knst-wrk/ipled/DSCF0306.JPG

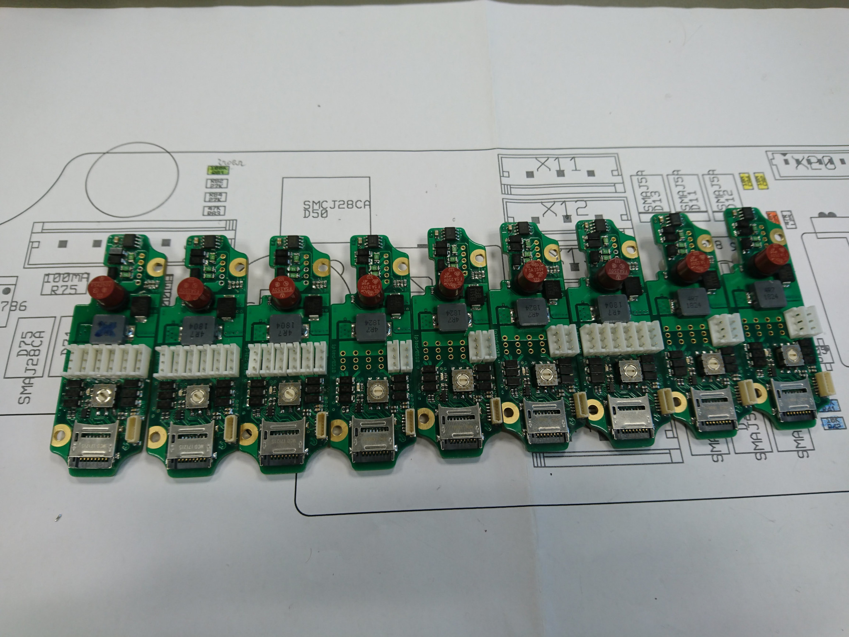
DSCF0306.JPG
