knst-wrk/ipled/DSCF5322.JPG

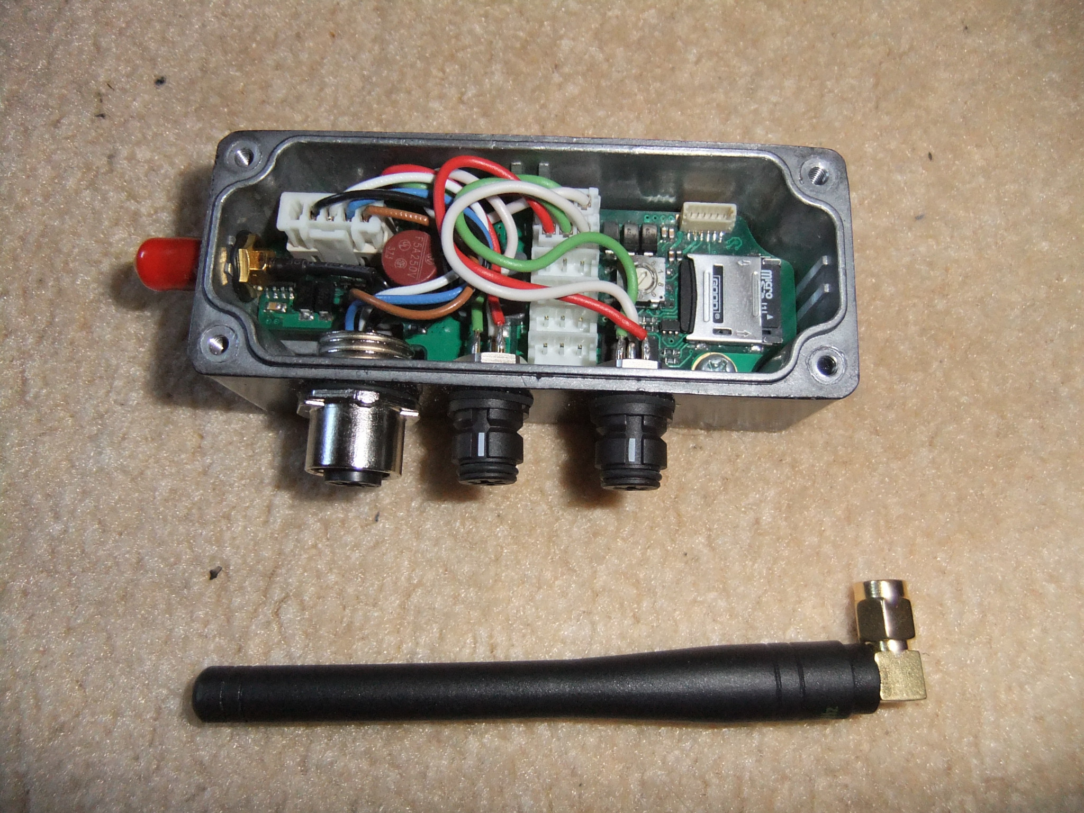
DSCF5322.JPG
