knst-wrk/ipled/rfspec.png

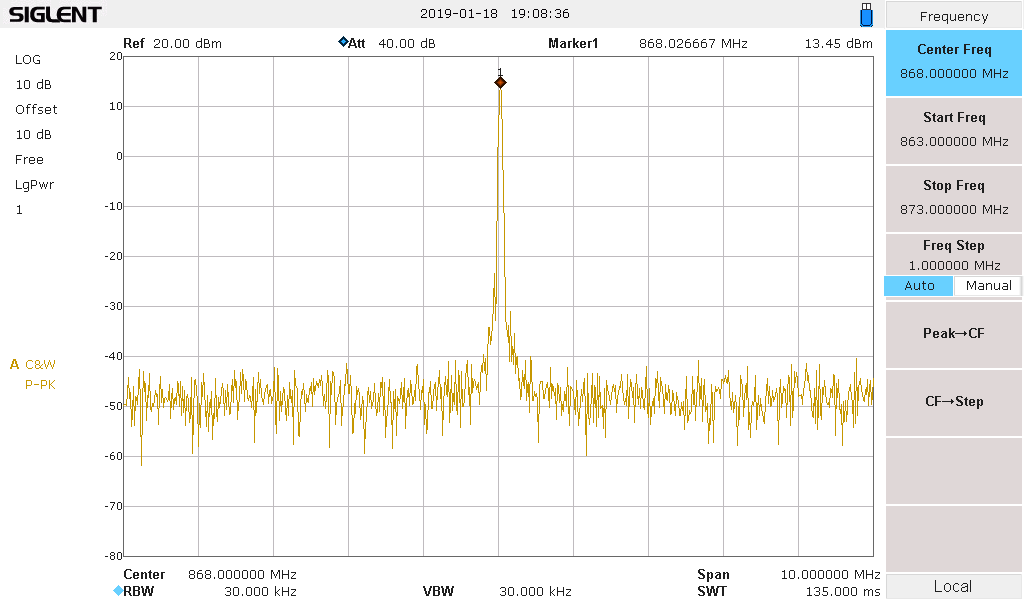
rfspec.png
