knst-wrk/ipled/hw/ipled.pdf

# STM32F103C VBAT VSSA VDDA

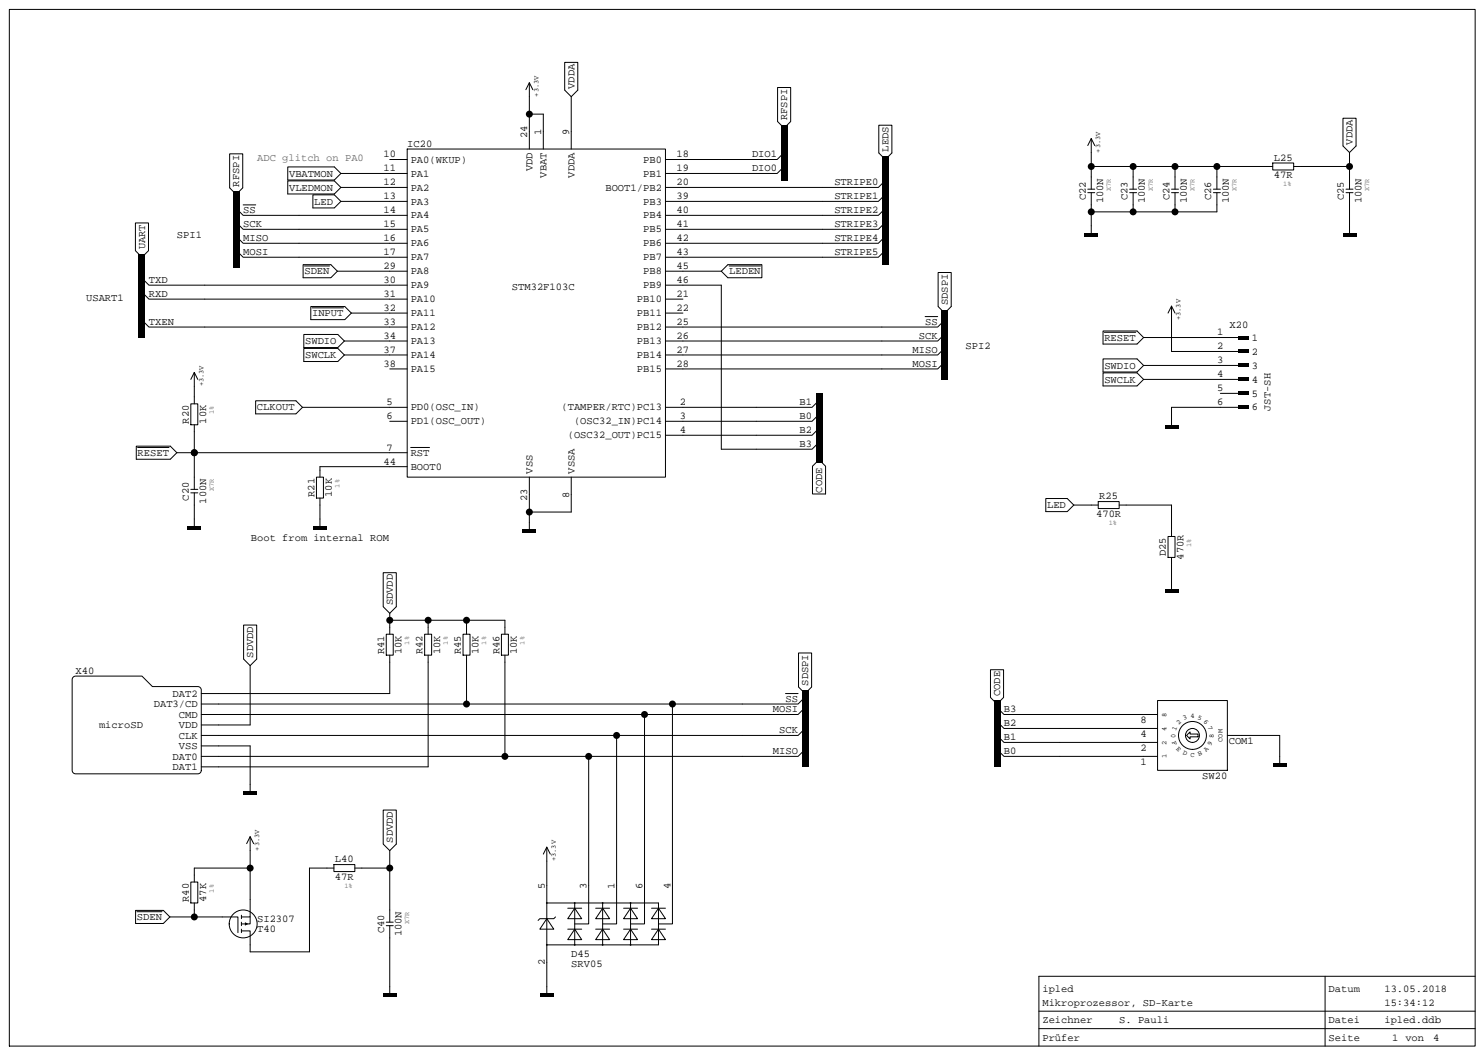
[picture p4: page 1]

Boot from internal ROM

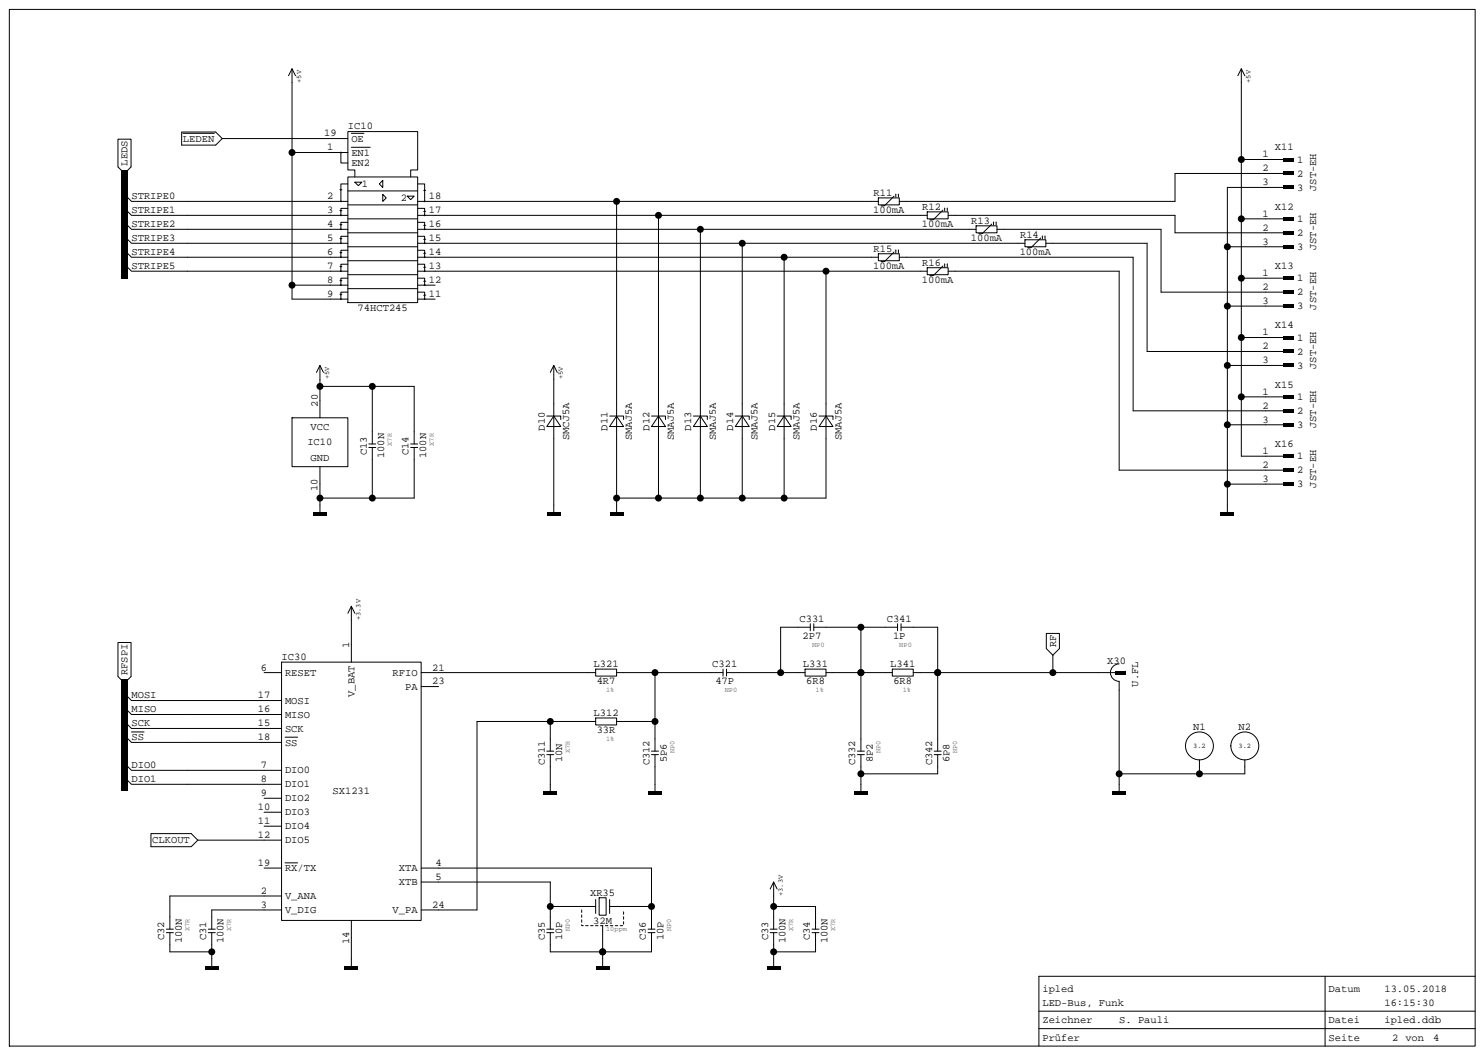
[picture p5: page 2]

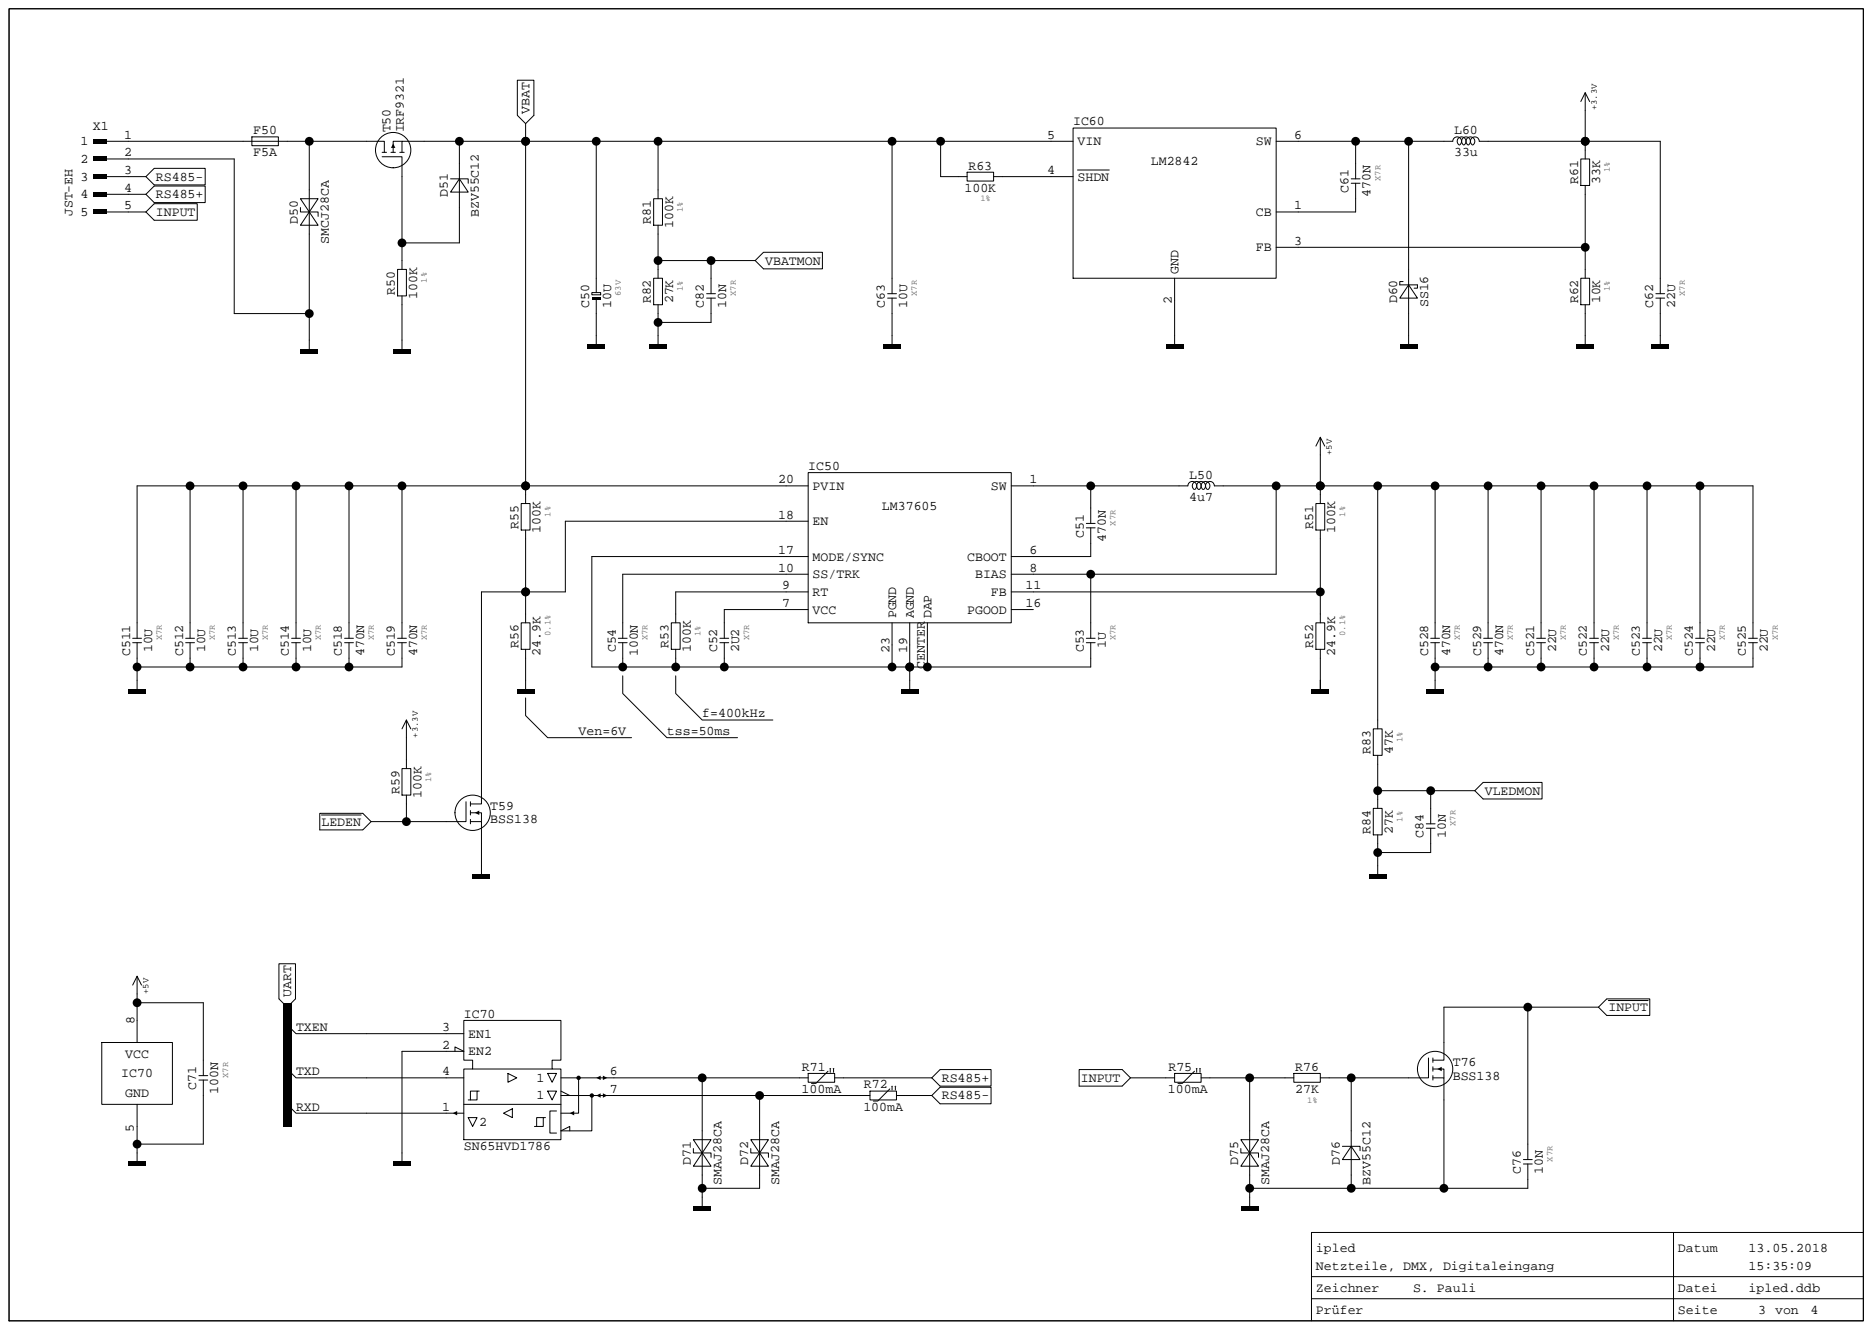
[picture p6: page 3]

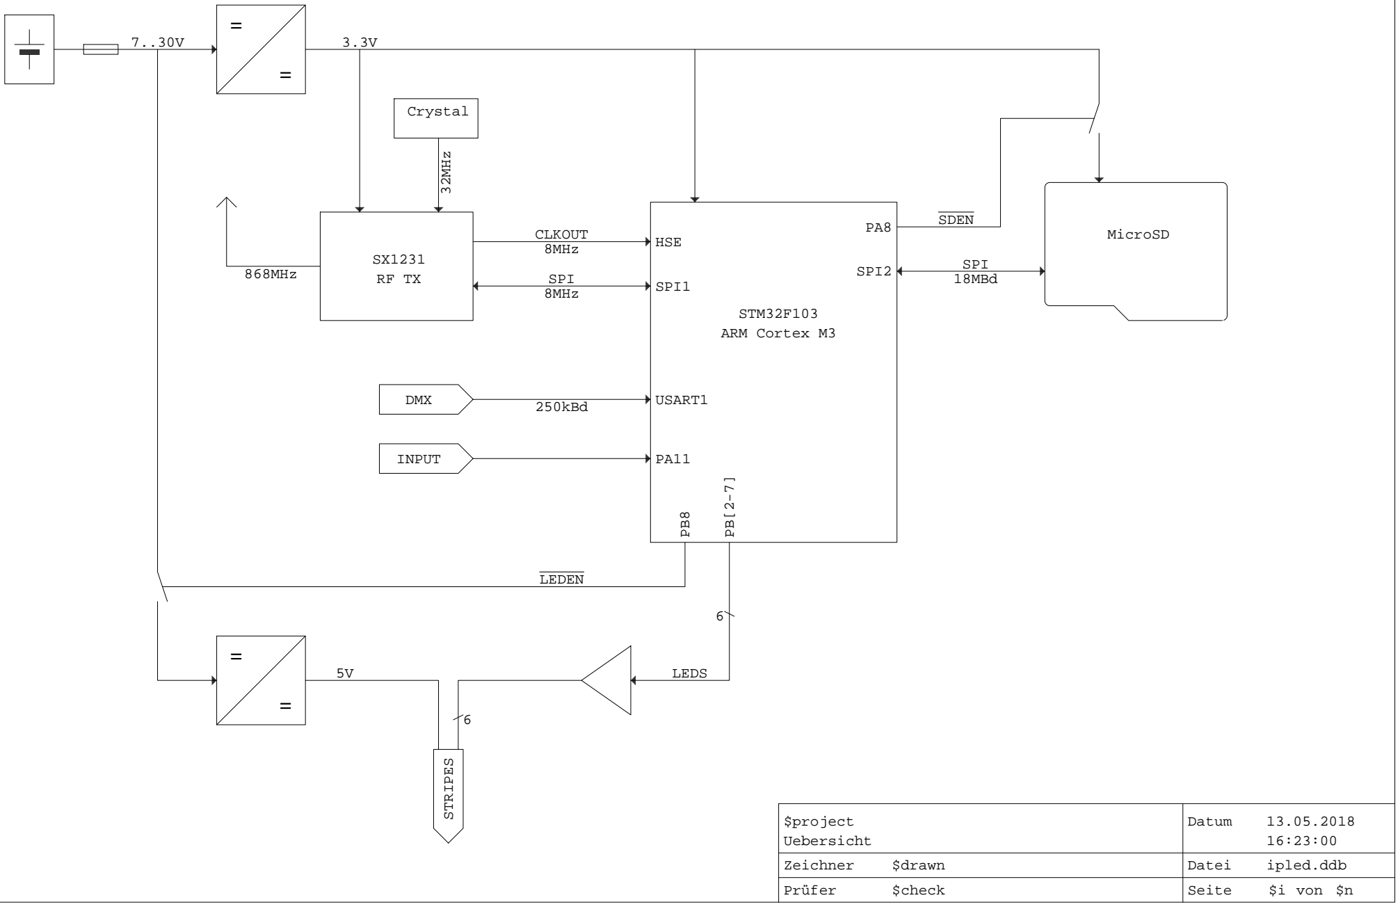
[picture p7: figure]
ARM Cortex M3; STM32F103; SPI; SPI1; HSE CLKOUT 8MHz; DMX; USART1; 250kBd; 868MHz; 8MHz; Crystal32MHz; SPI2; INPUT; LEDEN; LEDS; STRIPES; MicroSD; SPI 18MBd; SDEN; Seite; $i von $n; Datum; Zeichner; $drawn; ipled.ddb; Prüfer; $check; Uebersicht; $project
