knst-wrk/ipled/hw/assembly.pdf

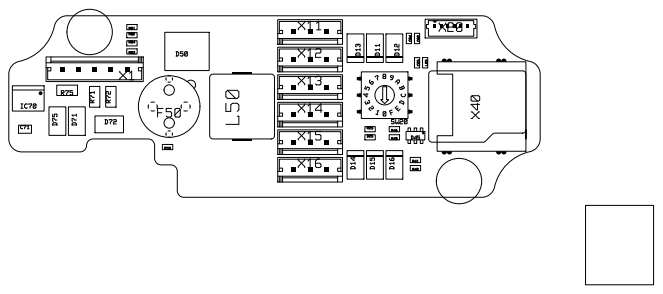
[picture p8: page 1]

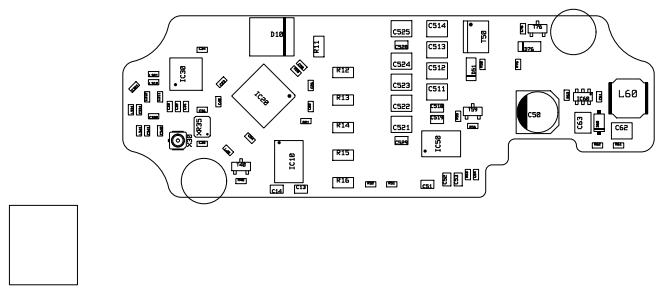
[picture p9: page 2]
