knst-wrk/ipled/hw/enclosure.pdf

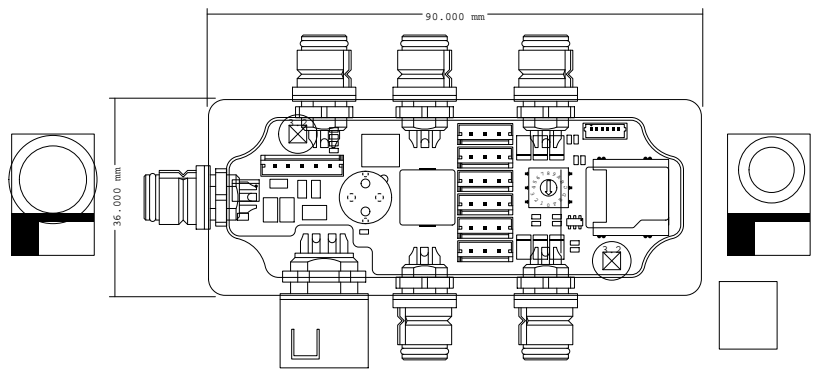
[picture p10: page 1]
